AlexCpGo/ECE445/Documents/Final/img/WebPage.png

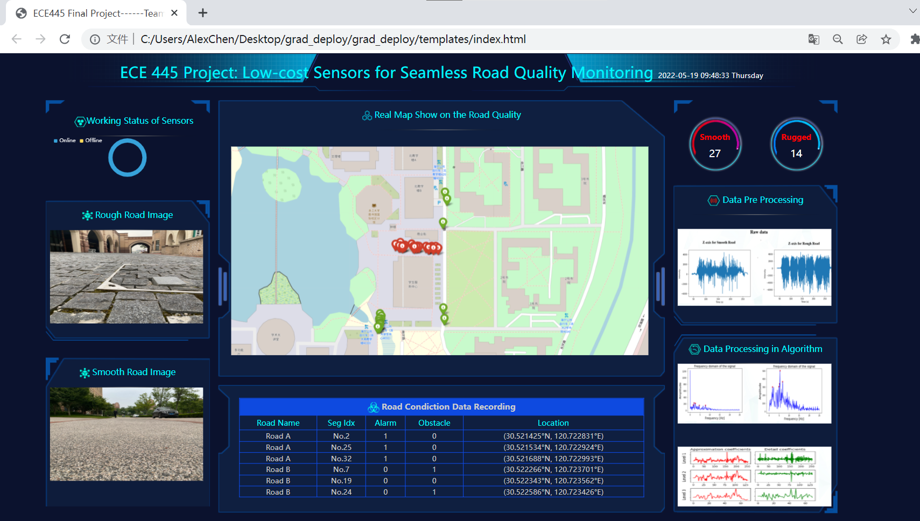
Documents/Final/img/WebPage.png
