AlexCpGo/ECE445/README.md

# LOW-COST SENSOR FOR SEAMLESS ROAD QUALITY MONITORING
An project involves hardware and software interactions 
### Sp2022 Team 11

### 1. Abstract
In this project, our group designed a low-cost sensor to collect road data, aiming at conveniently
reporting the quality of seamless roads. To achieve this target, we designed an
inexpensive device with an accelerometer and a GPS chip. Our device could be fixed on
the bicycle with a device holder and then transmit data to the server. Machine learning
models have been created to process acceleration data and judge the road quality. When
abnormal patterns appeared, message where the patterns locate would be produced and
sent to our display system. Locations with problems could be visualized on a city map
constantly and could be accessible for users via web browsers as clients...

###### Key Word
Road quality monitoring; Acceleration; Arduino; Esp8266 WIFI module; Fourier Transform; Logistic regression; SVM; Random Forest; Python Flask; Display Webpage;

### 2. Block Diagram
###### ------------------------- Figure 1. Block Diagram of the project -------------------------


### 3. Device System
###### ------------------------- Figure 2. Overlook of Device System -------------------------
DeviceSystem
###### ------------------------- Figure 3. Test On Device -------------------------
test
###### ------------------------- Figure 4. Device Interface Schematic -------------------------
Device Interface Schematic

### 4. Hardware Component
###### ------------------------- Figure 5. Acceleration Sensor Module: MPU6050 -------------------------
MPU6050
###### ------------------------- Figure 6. GPS Module: NEO-6M -------------------------
NEO6M
###### ------------------------- Figure 7. WIFI Module: esp8266 -------------------------
esp8266
###### ------------------------- Figure 8. MCU: STEMTeraBOARD -------------------------
MCU
###### ------------------------- Figure 9. Battery Supply: 9V Ni-MH Battery -------------------------
battery

### 5. Data Transmission
The first part is Hardware part. The Arduino will integrate the signal collected from accelerometer
and GPS. It will write the data to the serial. The second part is the connection
between Hardware and server part. The serial data will be transmitted to computer using
the wire connected. The computer can receive the data through port. The third part
is the python script on computer which uses the data received from port to form log.
The fourth part is the data preprocessing implemented on server. It will get the signal
of accelerometer and GPS and form the array that can be accepted by the classification
subsystem.
###### ------------------------- Figure 10. Data Transmission Flow -------------------------
data_transmitting

The script of forming log keeps running. Once port receives data, the script starts get the
data from port and write it on the log. Then, once the port is disconnected, the recording
will finish. The format of log is illustrated below.
Every couple of data contains two rows. The first row is records the second. Is used to
show the sample rate. The second row records the data from accelerometer and GPS. The
format of this row is (longitude, latitude, second. x-acc y-acc z-acc). Though there is also
time recorded, it is not updated in enough frequency, so it is not used in our system.
log

### 6. Data Pre-processing
The preprocessing part on server is a script. Once a new log is detected, the preprocessing
module will start to work. It first read the log and exclude the row without useful
information. Then it will get couple of rows need to be further processed. The first row,
which shows the time will recorded in a list. The second rows will be processed through
regular expression to get the signal from accelerometer and GPS.
After we get the raw data, we need to do resampling, because of the need of Fourier
Transform and Wavelet Transform. The signal from accelerometer and GPS recorded in
one second will be combined into a list.
For signal from accelerometer, we will use interpolation algorithm to resample each list
to 50Hz. 50Hz is chosen because the sample rate of our raw data is 40Hz 50Hz.
Finally, the lists recorded in Ten consecutive seconds will be combined into a segment.
The signal from accelerometer will form an array with dimension of (3, 500). 3 represents
three axes of accelerometer. 500 represents ten seconds of signal with sample rate with
50Hz. The signal form GPS will be a tuple of longitude, latitude, which is the tuple with
middle index from list combined.
The data from accelerometer will be sent to classification subsystem and data from GPS
will be sent to display subsystem.

### 7. Data Processing Algorithm
###### 7.1 General Processing Procedure
The classification subsystem mainly includes two parts, feature extraction and machine
learning model.
A method of feature extraction should be chosen to make the abnormal pattern can be
more easily recognized by model.
The machine learning model will need to use the feature extracted to classify the road as
accurately as possible. In addition, the speed of processing needs to be within 0.1s for
each segment.
There two tasks for the machine learning model. First, it should classify the condition
of roughness of the road. Second, it should distinguish whether there is obstacle on the
road. We will test the method from [1], which includes two method of feature extraction,
and three machine learning model. After testing, we will choose the best combination
and implement it on our server.
After we get the result, the label will be labeled on the map according to the signal form
GPS.
Procedure

###### 7.2 Processing Algorithm Method: Fourier Transform + Machine Learning
###### ------------------------- Figure 11. Raw Data Frequency -------------------------
Z
###### ------------------------- Figure 12. FFT -------------------------
Frequency
###### ------------------------- Figure 13. Wavelet -------------------------
Dicrete Wavelet Tranform
###### ------------------------- Figure 14. Feature Extraction ------------------------- 
Z_processed

### 8. Display System
###### -------------- Figure 15. Figure Map Marks automatically produced using Python ----------------
map
###### 
###### -------------- Figure 16. Webpage automatically produced using html+javascript-----------------
WebPage

### 9. Refernce
Documents/Final/final_report
