AlexCpGo/ECE445/Meeting/week7.pptx

Team 11: Low-cost sensor for seamless road quality monitoring

Goal: Utilizing the information collected by the sensors on vehicles to monitor the real-time road quality

Team: Yuhang Chen, Zhengwei Dai, Yichen Li, Yihang Yang

## Slide 2

SMART goals

4.3

4.10

…

4.24

- Sensor testing
- Server design
- Survey for filtering subsystem and feature extraction

- Connection between sensor and microcontroller
- WIFI module building
- Survey for segmentation subsystem and classification

- Build the PCB board
- Implement the data process on server
- Send signal from PCB to server

## Slide 3

Tasks

Sensor

- Purchase and check the model and PIN of each sensor is correct
- Test the data output of each sensor on the bread board
- Connect the sensors to MCU and test data transmission

Filtering

1. Apply fft to observe cut-off frequency of sensors
2. Low-pass filter for acceleration+ High-pass filter for angular velocity
3. Attitudinal Data Calculation with
1. Linear Kalman Filter
2. First Order Complementary Filter

Server

Step1. Connect ESP8266 with Stem32
Step2. Initialize ESP8266 Model: AP and STA mode
Step3. Establish TCP/IP and use python socket to build TCP/IP
Step4. Use python flask and html to build the HTTP server
Step5. Sent data from Stem32 by IP address

Feature extraction

- FFT to analyze the overall situation of the road. (roughness)
- DWT to analyze the problems happen in part of the road. (normal, pothole, and transverse)
