AlexCpGo/ECE445/Documents/Final/img/dataTrans.png

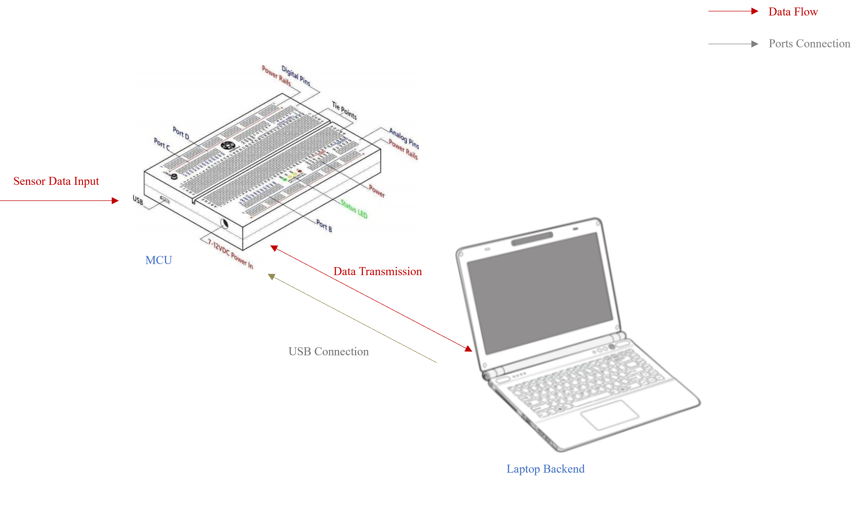
Documents/Final/img/dataTrans.png
