AlexCpGo/ECE445/Documents/Final/img/telephone.jpeg

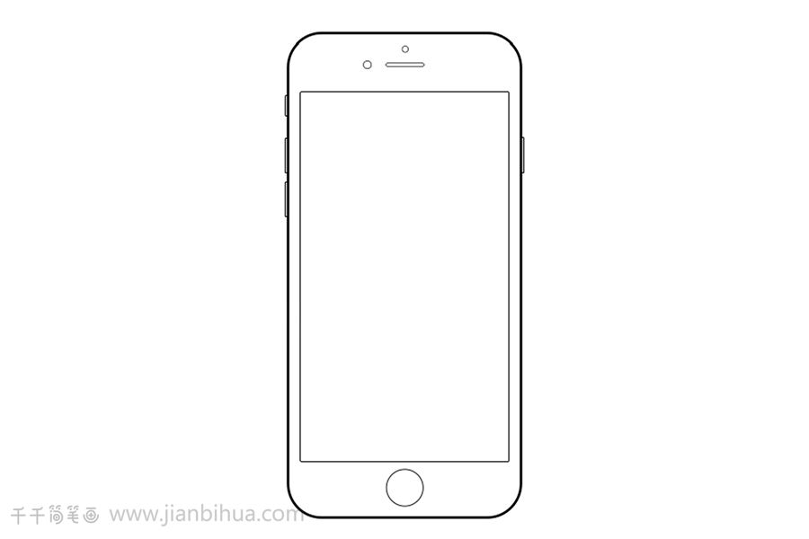
Documents/Final/img/telephone.jpeg
