AlexCpGo/ECE445/Documents/IPR/computer.jpeg

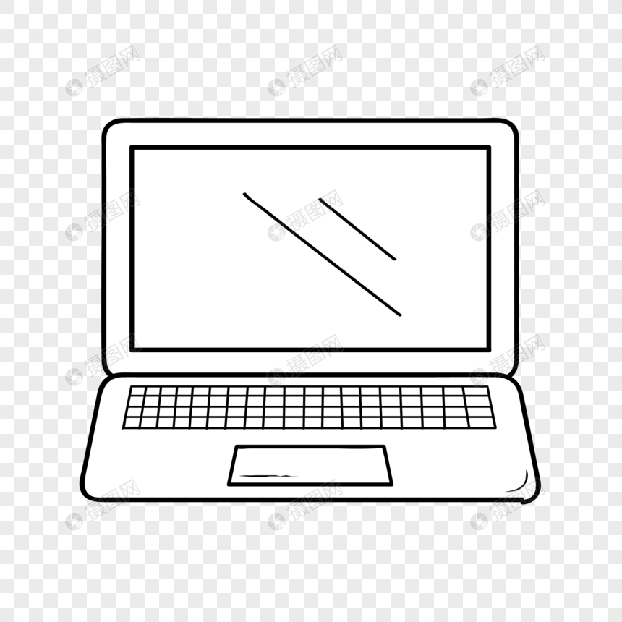
Documents/IPR/computer.jpeg
