AlexCpGo/ECE445/Documents/Notebook/block diagram.png

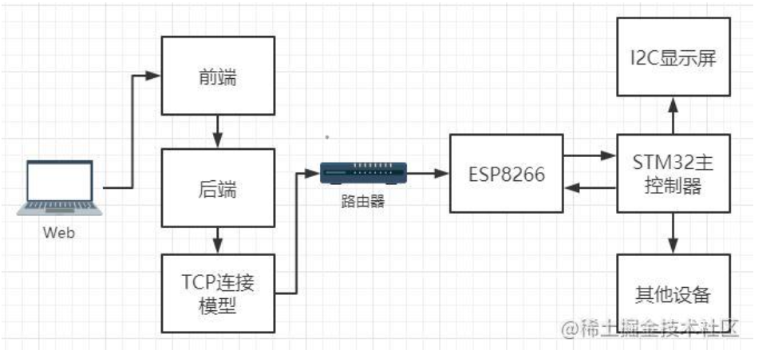
Documents/Notebook/block diagram.png
