AlexCpGo/ECE445/Documents/Notebook/css.png

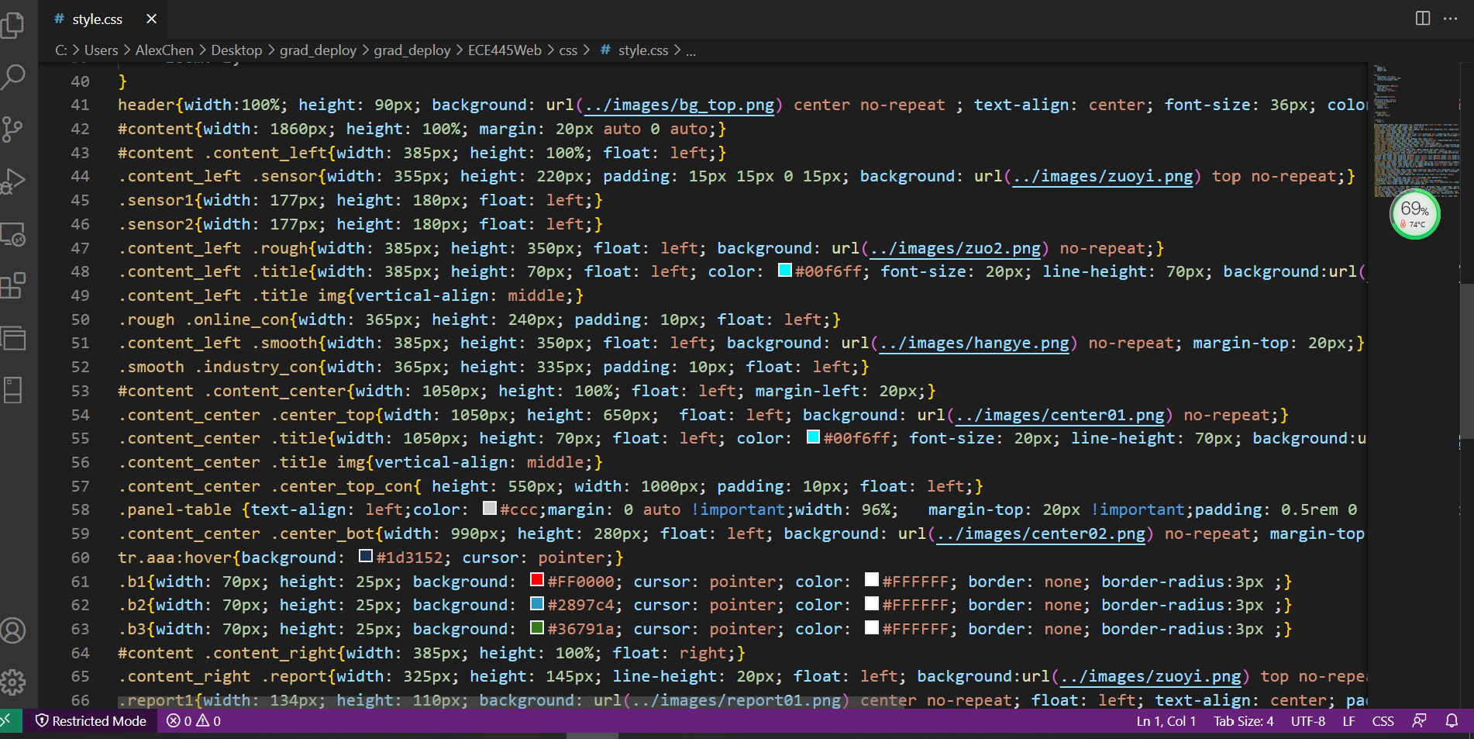
Documents/Notebook/css.png
