AlexCpGo/ECE445/Documents/Notebook/git.png

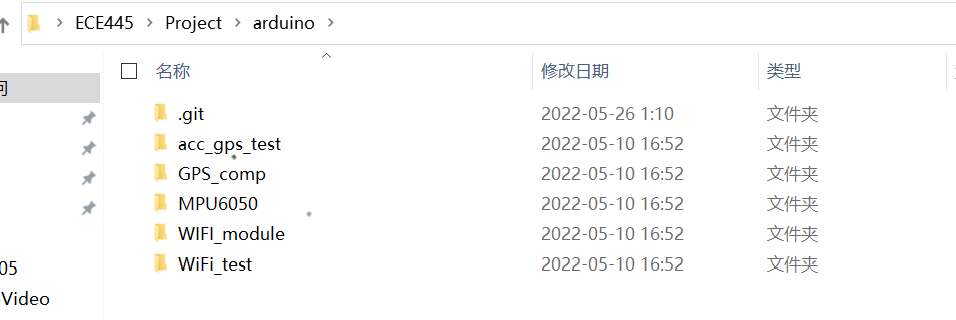
Documents/Notebook/git.png
