AlexCpGo/ECE445/Documents/Notebook/js.png

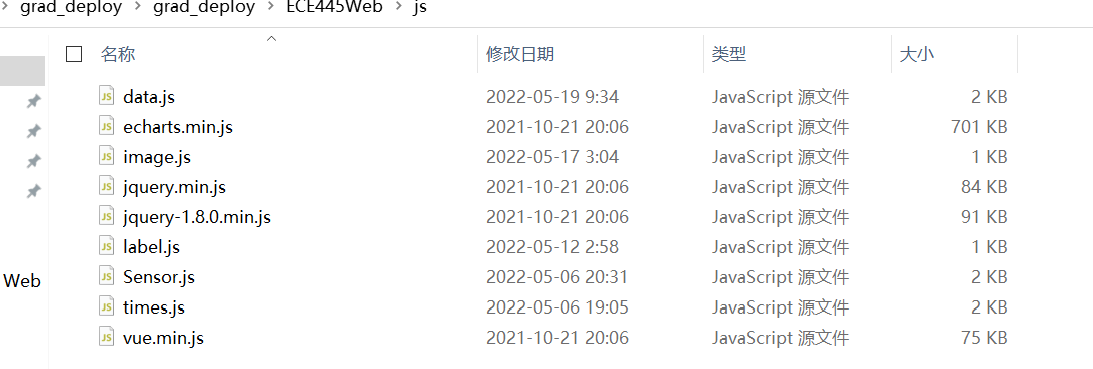
Documents/Notebook/js.png
