AlexCpGo/ECE445/Documents/Notebook/sensors-20-05564-g001.webp

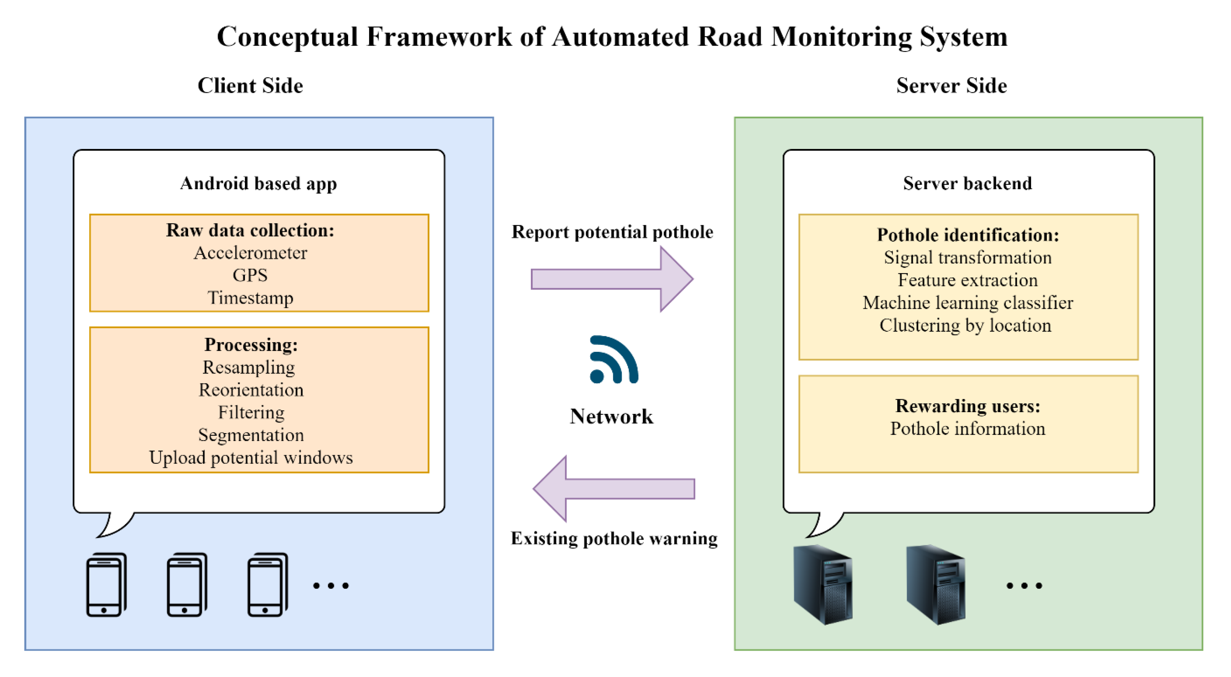
Documents/Notebook/sensors-20-05564-g001.webp
