AlexCpGo/ECE445/Documents/Notebook/web.png

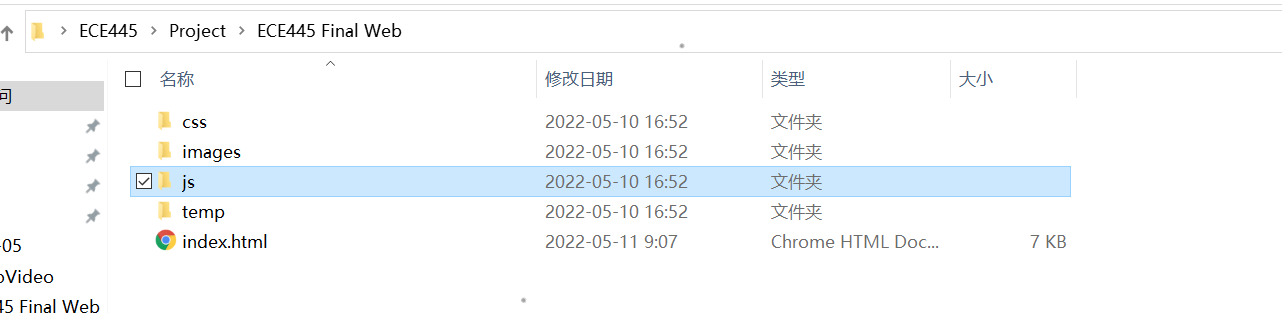
Documents/Notebook/web.png
