AlexCpGo/ECE445/Project/Display_System/images/bg_data.png

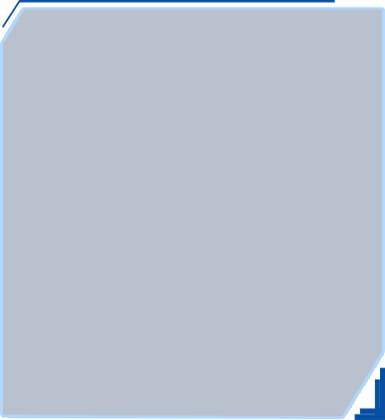
Project/Display_System/images/bg_data.png
