AlexCpGo/ECE445/Project/Display_System/images/data1.png

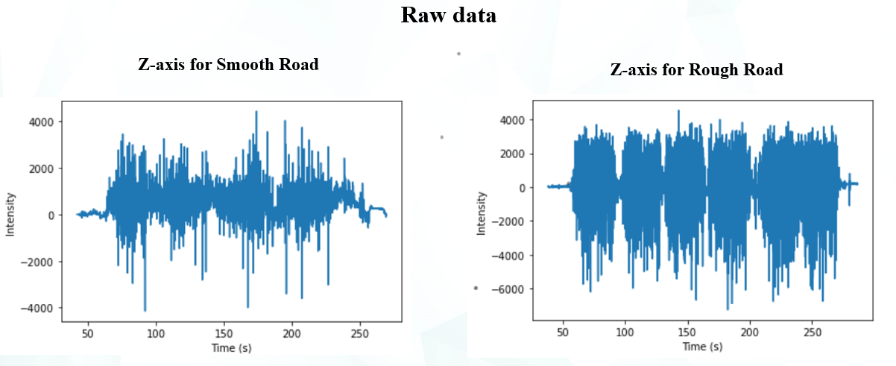
Project/Display_System/images/data1.png
