AlexCpGo/ECE445/Project/Display_System/images/data2.png

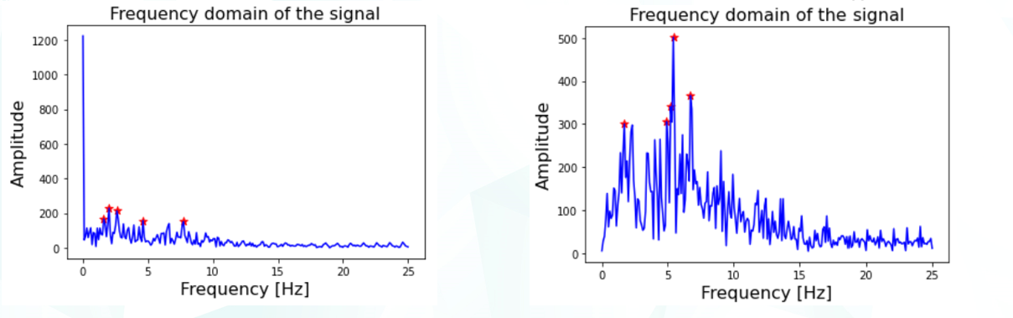
Project/Display_System/images/data2.png
