AlexCpGo/ECE445/Project/Display_System/images/data3.png

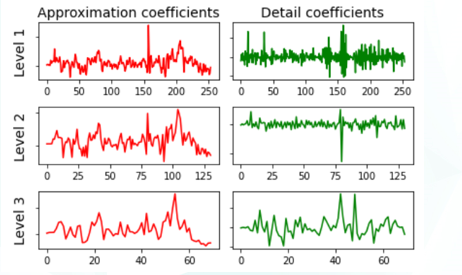
Project/Display_System/images/data3.png
