AlexCpGo/ECE445/Project/Display_System/images/map.png

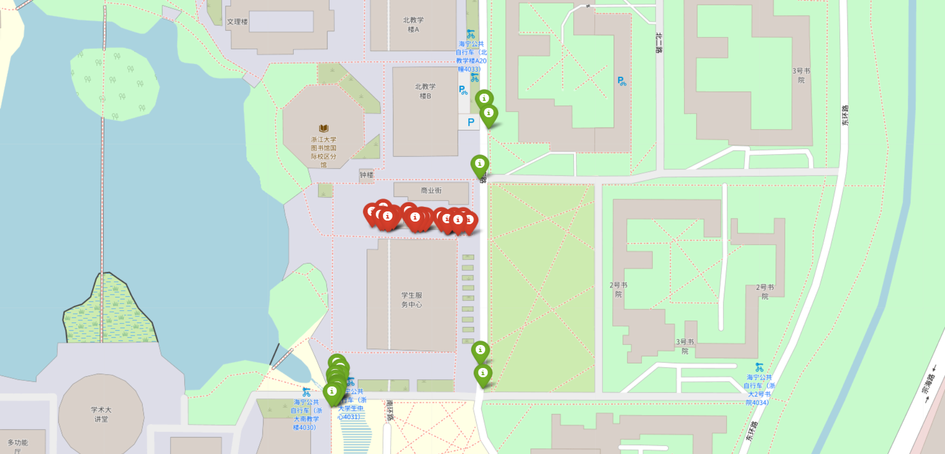
Project/Display_System/images/map.png
