AlexCpGo/ECE445/Documents/Notebook/bugs.png

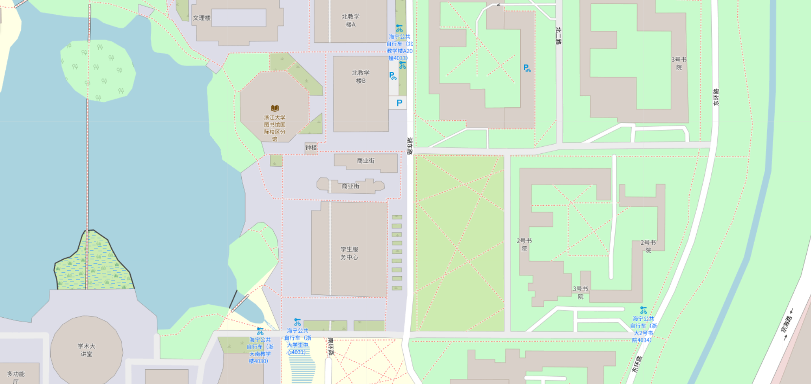
Documents/Notebook/bugs.png
